ThisIsntTheWay/nixie_clock/resources/gerber/README.md

# Gerber files
This directory hosts various gerber files once they're ready for release.
