ThisIsntTheWay/nixie_clock/REFERENCES.md

# References
This document contains datasheets or various pinout diagrams/graphics for all the components used in this project.  
Note: None of the graphics are made by me and are just direct links to the source.

- [SN74HC595N - Shift register](https://i.imgur.com/DETzh7g.png)</br>
- [ESP32 (**Dev Kit**)](https://i2.wp.com/randomnerdtutorials.com/wp-content/uploads/2018/08/ESP32-DOIT-DEVKIT-V1-Board-Pinout-36-GPIOs-updated.jpg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)</br>
- [K155ID1 - BCD-To-DEC converter](https://tubehobby.com/datasheets/k155id1.pdf)</br>
  - [Example wiring](https://cdn.hackaday.io/images/408171416055153702.png)</br>
- [IN-16 - Nixie tube (RU)](https://tubehobby.com/datasheets/in16.pdf)
  - [Pinout graphic](http://www.tube-tester.com/sites/nixie/data/in-16/IN-16-pinout.jpg)
