ThisIsntTheWay/nixie_clock/resources/schematics/schematic_clock_direct_drive_REV4-BELOW.png

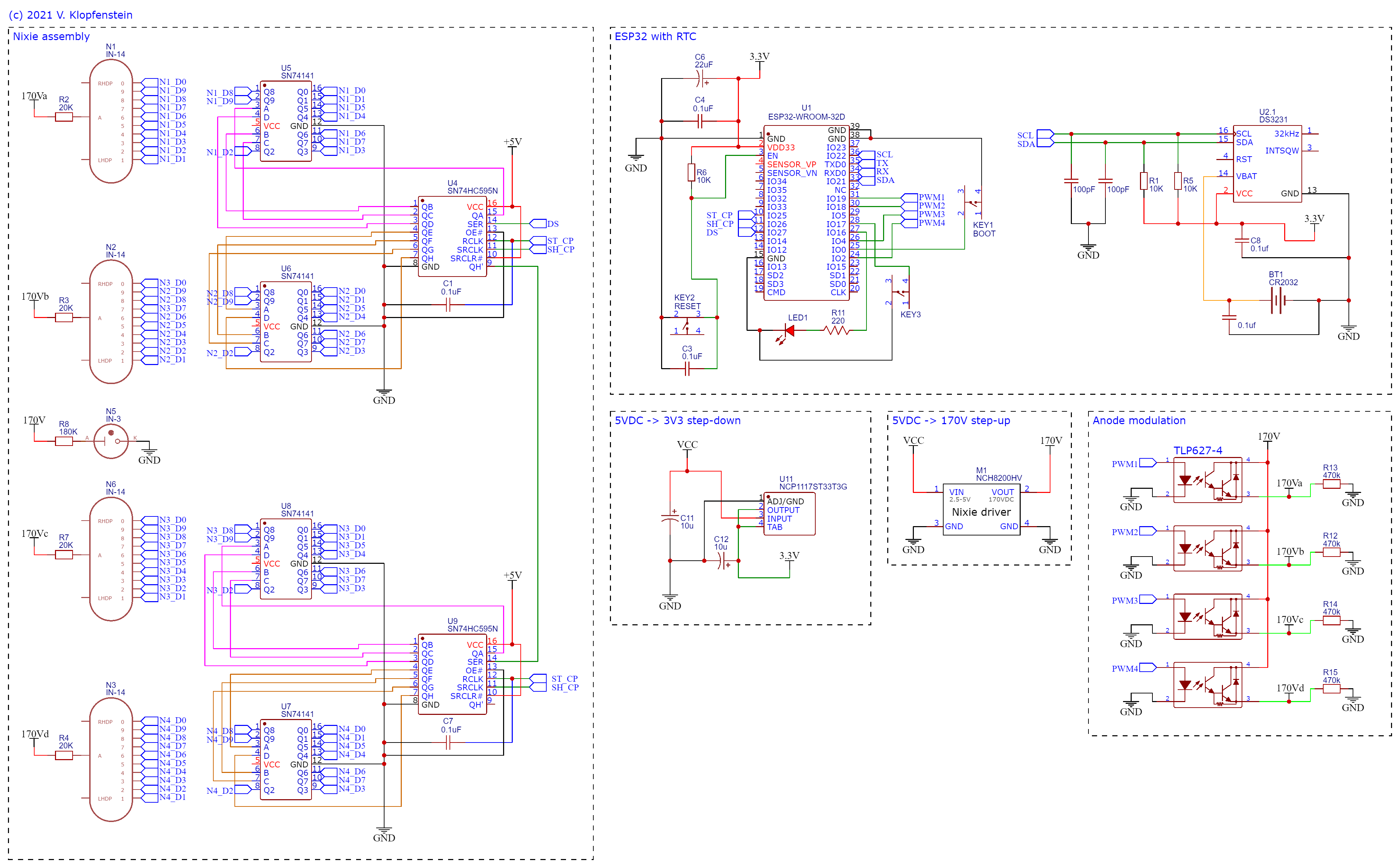
resources/schematics/schematic_clock_direct_drive_REV4-BELOW.png
