ThisIsntTheWay/nixie_clock/resources/schematics/schematic_clock_direct_drive_REV5-UP.png

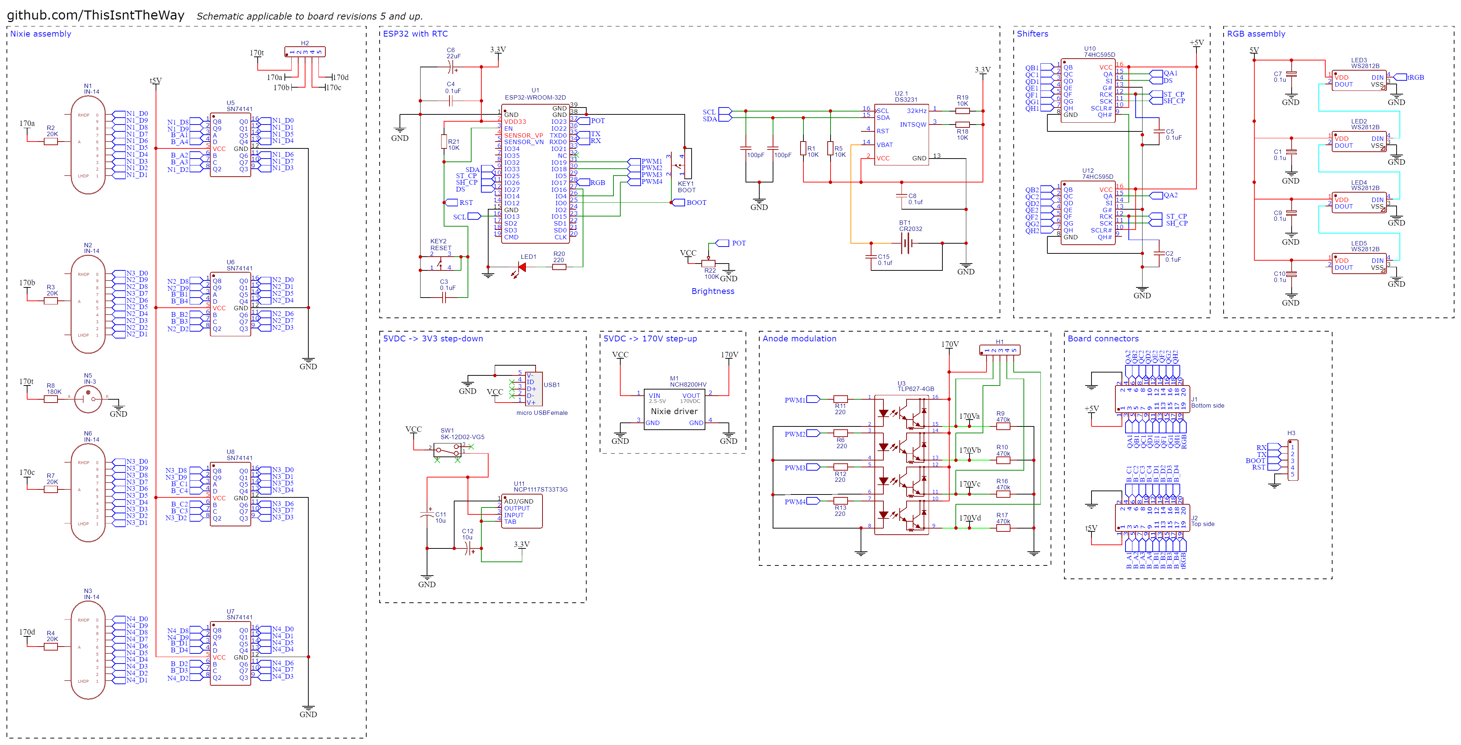
resources/schematics/schematic_clock_direct_drive_REV5-UP.png
