ThisIsntTheWay/nixie_clock/resources/3d_prints/in14_socket_v1.stl

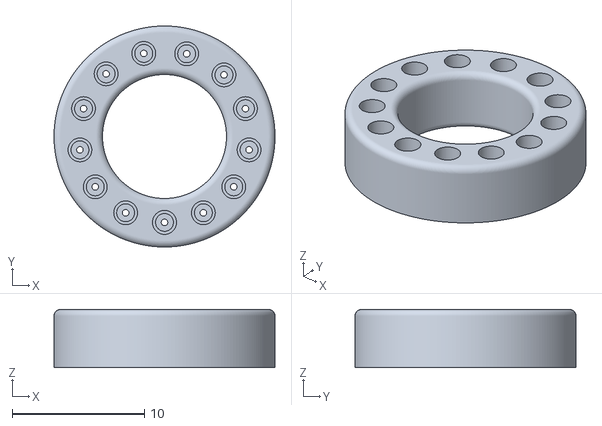
[picture p3: CAD file, 2021-08-19]
resources/3d_prints/in14_socket_v1.stl
16.7 x 16.7 x 4.40
