ThisIsntTheWay/nixie_clock/resources/3d_prints/README.md

## 3D Prints
This folder contains STLs of 3D printable models.  

### IN-14 Holder
  
Made for PCB footprints with the following dimensions:  
