ThisIsntTheWay/nixie_clock/(threads)

Thread 2 (2021-04-08):

Crash on FS mount

ThisIsntTheWay, 2021-04-08:
This has occurred after OTA partition removal and implementation of config files for network settings:
```
(MCU START)
[i] Spawning tasks...
[T] FS: Mounting...
[i] Done with setup().
[i] Free heap: [T] RTC: Starting setup...299568[T] Nixie: preparing nixie updater...
.
[io\lib
deps\esp32doit-devkit-v1\LittleFS_esp32\src\lfs.c:998:error: Corrupted dir pair at {0x0, 0x1}
E (80) esp_littlefs: mount failed,  (-84)
E (83) esp_littlefs: Failed to initialize LittleFS
[E][LITTLEFS.cpp:56] begin(): Mounting LITTLEFS failed! Error: -1
```

ThisIsntTheWay, 2021-04-08:
Fixed by re-introducing mklittlefs.exe as a replacement to PIOs native LittleFS binary builder.

Thread 3 (2021-05-17):

Time is sometimes invalid

ThisIsntTheWay, 2021-05-17:
Sometimes, RTClib produces invalid data, either because the RTC produces garbage or due to some other reason.
This leads to the nixie tubes not updating.

ThisIsntTheWay, 2021-05-19:
Next step: Investigate I2C signal.
Maybe add low-capacitance caps connecting the signals to GND.

ThisIsntTheWay, 2021-05-19:
Analysis has shown that the I2C clock line is fairly noisy.

Lowering the master I2C clock speed to 100kHz has largely mitigated, but not completely eradicated the issue.
However, RTClib now interprets the I2C data far less erroneously;
(It is within margin of error)

This issue is thus considered **fixed**, but will not be closed unless the error can be completely eradicated.

The aforementioned fix has been implemented in commit b108fdec81536a9b99450268fd336ffe5f6cfa82.

ThisIsntTheWay, 2021-05-19:
This issue has been further mitigated with the addition of two 47pF caps on both the data and clock lines;
```
SDA -- 47pF -- GND
SCL -- 47pF -- GND
```
Some instances with garbage data still exist though,

ThisIsntTheWay, 2021-06-01:
Confirmed fixed with the addition of 100pF caps on both I2C lines.

Closed 2021-06-01.

Thread 5 (2021-05-19):

Websockets server stalls on WiFi scan

ThisIsntTheWay, 2021-05-19:
Due to its implementation, the websockets instance stops responding to client messages during a WiFi scan.
This is a low-priority fix.

ThisIsntTheWay, 2021-06-20:
This phenomena is too low-priority to give attention to.

Closed 2021-06-20.

Thread 6 (2021-05-19):

Websockets server broadcasts messages to all clients

ThisIsntTheWay, 2021-05-19:
Currently, the websockets server sends its messages to all clients.
Whilst this is not a real problem, it would be nice to have the server send their messages to the actual origin.

ThisIsntTheWay, 2021-05-19:
Implemented in commit b95afe7c07b06c8e006aabfe8a15a01c8cc466dd

Closed 2021-05-19.

Thread 7 (2021-06-07):

Multiple definitions

ThisIsntTheWay, 2021-06-07:
After initially implementing classes, the compiler fails during the linking process due to multiple definitions:
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

Currently, #includes are nested like this:
```
main.cpp
	tasks.h
		nixie.h
			rtc.h
				sysInit.h
		rtc.h
			sysInit.h
	webserver.h
		rtc.h
			sysInit.h
		philipsHue.h
			sysInit.h
		nixie.h
			rtc.h
		utils.h
			sysInit.h
```

ThisIsntTheWay, 2021-06-20:
Implementation of classes will be pushed back, this issue will not be handled momentarily.

Closed 2021-06-20.
