ThisIsntTheWay/nixie_clock/(list of files, drawings)

Other design files:
resources/SCH_Nixie clock - v2_2021-07-23.json
