ThisIsntTheWay/nixie_clock/src/displayController.cpp

#include <displayController.h>
#include <timekeeper.h>

#define PULSATE_INTERVAL 5
#define MAX_PWM 150

/* -------------------
    Vars
   ------------------- */

Nixies nixies(DS_PIN, ST_PIN, SH_PIN);

int DisplayController::TubeVals[4][2] = {{9, 170}, {9, 170}, {9, 170}, {9, 170}};

bool DisplayController::AllowRESTcontrol = true;
bool DisplayController::DoDetox = false;
bool DisplayController::Clock = true;

uint8_t DisplayController::OnboardLedPWM = 20;
uint8_t DisplayController::OnboardLEDmode = 0;
uint8_t DisplayController::OnboardLEDblinkAmount = 0;
uint8_t DisplayController::DetoxCycle = 0;

DetoxInfo DisplayController::detoxInfo;

/* -------------------
    Main
   ------------------- */

void taskSetDisplay(void* parameter) {
    while (!nixies.IsReady()) {
        vTaskDelay(200);
    }

    Timekeeper timekeeper;

    for (;;) {
        int msMultiplier = 1;
        int t[4] = {11, 11, 11, 11};

        if (!timekeeper.RtcHealthy) {
            DisplayController::OnboardLEDmode = 2;
            DisplayController::OnboardLEDblinkAmount = 4;
        }

        if (DisplayController::Clock) {
            DisplayController::TubeVals[0][0] = timekeeper.time.hours / 10;
            DisplayController::TubeVals[1][0] = timekeeper.time.hours % 10;
            DisplayController::TubeVals[2][0] = timekeeper.time.minutes / 10;
            DisplayController::TubeVals[3][0] = timekeeper.time.minutes % 10;
        }
        
        if (!DisplayController::DoDetox) {
            // Normal routine
            for (int i = 0; i < 4; i++) {
                int8_t tubeVal = DisplayController::TubeVals[i][0];
                int8_t tubePWM = DisplayController::TubeVals[i][1];

                t[i] = tubeVal;

                // Fully turn off tube instead of leaving cathodes floating.
                if (tubeVal > 9)    { ledcWrite(i, 0); }
                else                { ledcWrite(i, tubePWM); }
            }

            nixies.SetDisplay(t);
        } else {
            // Detox cycle
            if (DisplayController::DetoxCycle <= 10) {
                msMultiplier = 75;
                for (int i = 0; i < 4; i++) {
                    t[i] = DisplayController::DetoxCycle;
                }

                DisplayController::DetoxCycle++;
                nixies.SetDisplay(t);
            } else {
                DisplayController::DetoxCycle = 0;
                DisplayController::DoDetox = false;
            }
        }
        
        vTaskDelay(TASK_TICK_DELAY * msMultiplier);
    }
}

// Status LED for ESP32
void taskSetStatusLED(void* parameter) {
    pinMode(ONBOARD_LED_PIN, OUTPUT);

    ledcSetup(ONBOARD_LEDC_CHANNEL, LEDC_PWM_FREQUENCY, 8);
    ledcAttachPin(ONBOARD_LED_PIN, ONBOARD_LEDC_CHANNEL);

    for (;;) {
        switch (DisplayController::OnboardLEDmode) {
            case 1:
                // Blink
                // -> LED is turned OFF but turns ON in a blinking matter
                for (int i = 0; i <= DisplayController::OnboardLEDblinkAmount; i++) {
                    ledcWrite(ONBOARD_LEDC_CHANNEL, DisplayController::OnboardLedPWM);
                    vTaskDelay(ONBOARD_LED_BLINK_INTERVAL);
                    ledcWrite(ONBOARD_LEDC_CHANNEL, 0);
                    vTaskDelay(ONBOARD_LED_BLINK_INTERVAL);
                }

                vTaskDelay(1000);
                break;
            case 2:
                // "Inverted" blink
                // -> LED is turned ON but turns OFF in a blinking matter
                ledcWrite(ONBOARD_LEDC_CHANNEL, DisplayController::OnboardLedPWM);
                for (int i = 0; i <= DisplayController::OnboardLEDblinkAmount; i++) {
                    ledcWrite(ONBOARD_LEDC_CHANNEL, 0);
                    vTaskDelay(ONBOARD_LED_BLINK_INTERVAL);
                    ledcWrite(ONBOARD_LEDC_CHANNEL, DisplayController::OnboardLedPWM);
                    vTaskDelay(ONBOARD_LED_BLINK_INTERVAL);
                }

                vTaskDelay(1000);
                break;
            case 3: {
                // Pulsate
                // Duty cycles above 150 are hardly perceived as brighter, so this value serves as the ceiling.
                for (int i = 0; i < MAX_PWM; i++) {
                    if (DisplayController::OnboardLEDmode != 3) break;

                    ledcWrite(ONBOARD_LEDC_CHANNEL, i);
                    vTaskDelay(ONBOARD_LED_PULSE_INTERVAL);
                }
                for (int i = MAX_PWM; i > 0; i--) {
                    if (DisplayController::OnboardLEDmode != 3) break;

                    ledcWrite(ONBOARD_LEDC_CHANNEL, i);
                    vTaskDelay(ONBOARD_LED_PULSE_INTERVAL);
                }
                break;
            }
            default:
                // Light up using specified PWM, a.k.a mode "0".
                ledcWrite(ONBOARD_LEDC_CHANNEL, DisplayController::OnboardLedPWM);
                break;
        }

        vTaskDelay(TASK_TICK_DELAY);
    }
}
