ThisIsntTheWay/nixie_clock/src/networkConfig.h

#ifndef NETCONFIG_H
#define NETCONFIG_H

#include <LITTLEFS.h>
#include <Arduino.h>
#include <ArduinoJson.h>
#include <WiFi.h>

class NetworkConfig {
    public:
        static String SSID;
        static String PSK;
        static bool IsAP;
        static bool IsStatic;
        static bool InInit;

        void InitConnection();
        bool WriteWiFiConfig(bool);
        bool WriteWiFiConfig(const char*, const char*);
        bool WriteWiFiConfig(const char*, const char*, bool);
        bool WriteIPConfig(JsonDocument&);
        bool ApplyNetConfig();

        String GetIPconfig(int8_t);

    private:
        String netFile = "/netConfig.json";

        const char* deviceIP;
        const char* netmask;
        const char* gateway;
        const char* dns1;
        const char* dns2;
        bool isStatic;

        bool parseNetConfig();
        void initSoftAP();
        bool splitIPaddress(char*, int*);
        
        const char *softAPssid = "Nixie Clock";
        const char *softAPpsk = "NixieClock123";
};

#endif
