ThisIsntTheWay/nixie_clock/src/terminalAux.h

#ifndef TERMINAL_H
#define TERMINAL_H

char vt_default_colour[] = "\x1B[39m";
char vt_red	[] = "\x1B[31m";
char vt_green	[] = "\x1B[32m";
char vt_yellow	[] = "\x1B[33m";
char vt_blue	[] = "\x1B[34m";
char vt_magenta	[] = "\x1B[35m";
char vt_cyan	[] = "\x1B[36m";
char vt_grey	[] = "\x1B[37m";

char vt_back_default_colour[] = "\x1B[49m";
char vt_back_red	[] = "\x1B[41m";
char vt_back_green	[] = "\x1B[42m";
char vt_back_yellow	[] = "\x1B[43m";
char vt_back_blue	[] = "\x1B[44m";
char vt_back_magenta	[] = "\x1B[45m";
char vt_back_cyan	[] = "\x1B[46m";
char vt_back_grey	[] = "\x1B[47m";

#endif
