ThisIsntTheWay/nixie_clock/(commit log)

2021-03-20 Webserver prototype
2021-03-20 RTC implementation (WIP)
    Create rtcConfig.cfg in SPI flash FS.
    Handling of contents is yet to be implemented.
2021-03-21 Fix kernel panic due to LittleFS
    [main.cpp, rtc.h, webServer.h]
2021-03-21 Fix template processing
    Template processor looks for strings with %%.
    It is required to use an additional % as an escape character.
    [main.cpp, webServer.h]
2021-03-21 Better handling of deserialization error
    [webServer.h]
2021-03-25 Short summary about file
    [main.cpp, nixie.h, philipsHue.h, rtc.h, webServer.h]
2021-03-26 New PCB
2021-03-27 Upload schematic
2021-03-27 getTime() return error if RTC is not ready
    [rtc.h]
2021-04-05 Update schematic... again
2021-04-06 Prod PCB Rev2
2021-04-07 Fix insufficient 'mode' length.
    [webServer.h]
2021-04-07 Fix RTC time update
    [nixie.h]
2021-04-07 Implement basic factory reset
    [main.cpp]
2021-04-07 Implement basic factory reset
    This time with more heap for the factory reset task.
    [main.cpp]
2021-04-07 Expose factory reset API endpoint
    [main.cpp, webServer.h]
2021-04-08 Remova OTA partition from MCU
    [part_no_OTA.csv]
2021-04-08 (Broken) Implement config file for network
    [main.cpp]
2021-04-08 Move schematic
2021-04-08 Add back mklittlefs.exe dep
    Turns out that the current code crashes if the FlashFS has been created without mklittlefs.exe
    [replace_fs.py]
2021-04-08 Add FS mount timeouts
2021-04-08 Move webserver startup into task
    This is kinda unnecessary, but I didn't want to have webServerStartup(); in the loop() function.
    [main.cpp, webServer.h]
2021-04-08 Skip NTP sync if ESP is in AP mode
    [rtc.h]
2021-04-08 Fix case sensitivity
2021-04-08 Improve error feedback and fix some errors
    [webServer.h]
2021-04-09 Fix rON & rOFF length threshold and remove comments
    [webServer.h]
2021-04-09 Better error handling in getHueLightIndex
    [philipsHue.h]
2021-04-09 Fix crash due to unsuccessful HTTP/GET
    The crash was due to ArduinoJson attempting to deserialize a HTTP GET stream that was invalid due to the ESP being unable to connect to the endpoint.
    To fix this, JSON parsing will only occur if http.GET() returns above 0
    [philipsHue.h]
2021-04-20 Work on fixing schedule for turning ON/OFF HUE lights.
    Does not yet turn on HUE lights, only off
    [philipsHue.h]
2021-04-20 Optimize code
    Implement decToBCD function to supersede the unnecessarily switch..case statement.
2021-05-15 Untested script to automatically remove libdep
    This script removes TinyWire from RTClib as a dependency, as it produces compiler errors on the ESP32 because it has no access to avr\interrupt.h
2021-05-15 Better handling of RTC failure
    No more crashing and improved verbosity.
    [rtc.h]
2021-05-16 Fix bitshift pins and logic
    [nixie.h]
2021-05-16 Fix nixie logic and add verbosity
    [nixie.h]
2021-05-16 Fix wrong display and implement manual nixie control
    This also fixes invalid time data from the RTC.
    [nixie.h]
2021-05-16 [Broken] Implement manual nixe display
    Produces HTTP/404 on valid GET request.
    [webServer.h]
2021-05-17 Fix invalid data length check for HUE API Endoint
    [webServer.h]
2021-05-17 Fix crash on deserialization error and improve feedback
    [philipsHue.h]
2021-05-17 Fix rOn & rOff filtering
    [webServer.h]
2021-05-17 New gerbers
2021-05-17 Improve deserialization error handling
    [rtc.h]
2021-05-17 Implement nixie tube control
2021-05-17 Change tube display and fix some if errors
    [webServer.h]
2021-05-19 Fix stack smashing protection failure
    Changed sprintf -> snprintf
    [rtc.h]
2021-05-19 Increase heap for taskUpdateRTC
    Stacktrace:
    CORRUPT HEAP: Bad head at 0x3ffd099c. Expected 0xabba1234 got 0x3ffd1ce0
    assertion "head != NULL" failed: file "/home/runner/work/esp32-arduino-lib-builder/esp32-arduino-lib-builder/esp-idf/components/heap/multi_heap_poisoning.c", line 249, function: multi_heap_realloc
    abort() was called at PC 0x4010e48f on core 0
    ELF file SHA256: 0000000000000000
    Backtrace: 0x4008906c:0x3ffd2bd0 0x400892e9:0x3ffd2bf0 0x4010e48f:0x3ffd2c10 0x4008da55:0x3ffd2c40 0x40081d64:0x3ffd2c60 0x40081dcd:0x3ffd2c80 0x400869a9:0x3ffd2ca0 0x4000bedd:0x3ffd2cc0 0x4017d3d6:0x3ffd2ce0 0x4017d463:0x3ffd2d20 0x4017df10:0x3ffd2d50 0x4017c6b1:0x3ffd2d70 0x4017c705:0x3ffd2d90 0x4017c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
    [main.cpp, rtc.h]
2021-05-19 Fix nixie clock mode not activating.
    [webServer.h]
2021-05-19 Workaround for 'bool manual' always being true
    [webServer.h]
2021-05-19 Fix websockets sending wrong SYS_DISMODE
    [webServer.h]
2021-05-19 Lower I2C clock speed to accommodate noisy SCL line
    RTClib interprets far less garbage with this change.
2021-05-20 Improve formatting of switch..case statement
2021-05-21 Fix logic, add time sanity check
    Removed minute comparisons for now
    [philipsHue.h]
2021-05-22 Update schematic
2021-06-06 Fix persistent NTP sync error
    Persistent as in the main menu (WebGUI) reporting an NTP sync error even though there was none (anymore).
    [webServer.h]
2021-06-06 Fix tube brightness reporting
    [webServer.h]
2021-06-06 Fix calculation of PWM as a percentage
    [nixie.h, webServer.h]
2021-06-06 Fix core panic due to HTTPClient
    displayCryptoPrice() and taskUpdateHUE() both used the same HTTPClient instance, thus crashing the core once either called http.end()
    [nixie.h, philipsHue.h]
2021-06-06 Workaround for brightness updates over REST
    [webServer.h]
2021-06-06 Remove unused 'Keep current' checkbox
2021-06-11 Increase PWM frequency
2021-06-11 Close nixie config file after switch..case
2021-06-11 Create/assign LED controller to individual opto channels
2021-06-11 Resolve race condition and increase PWM frequency
    [nixie.h]
2021-06-11 Fix opto pins again
    [nixie.h]
2021-06-11 Use separate RTC instances
    This hopefully fixes IntegerDivideByZero errors caused by DS3231::now().
    [nixie.h, philipsHue.h, rtc.h, webServer.h]
2021-06-11 Reboot system on network change
    [webServer.h]
2021-06-11 Fix cathode depoisoning logic
    [nixie.h]
2021-06-11 No longer print WiFi password in console
2021-06-11 Accommodate radio button CSS changes
2021-06-11 Omit brightness check if tubes should just get cycled
2021-07-23 Move files
    [SCH_Nixie clock - v2_2021-07-23.json]
2021-08-02 Major code rewrite
    [partition_table.csv]
2021-08-02 More I2C flexibility
2021-08-02 Prepare for board REV5
2021-08-02 Implement I2C slowmode flag
2021-08-09 Implement onboard LED
    For PCB REV5 and up
2021-08-09 Update RTC logic to board REV5
2021-08-09 Control onboard LED using LEDC
    Just to control the brightness.
2021-08-18 Add STL
    [in14_socket_v1.stl]
2021-08-18 Change PCB footprint image size
2021-08-19 i2c lock [WIP]
2021-10-03 Add more comments and fix incorrect register check during checkStartup()
    [rtc.cpp]
2021-10-03 Update oPins to newest PCB revision
2021-10-03 Update nixieTest.ino
    Lower initial PWM frequency
2021-10-04 Change changeDisplay() (untested)
    Also implement logic for inversed nixie socket footprints
2021-10-04 Fix numCache and BCD data arrangement
    [nixies.cpp]
2021-10-17 Add in missing '}'
    [main.cpp]
2021-10-17 Bootstrap system configuration JSON
    For now only contains a bool for keeping the onboard LED on post bootup procedure.
    Also moved some vars around.
2021-10-22 Resize filesystem
    Decrease SPIFFs space, increase OTA partitions.
    [partition_table.csv]
2021-10-22 Fix spiffs flash sector alignement
    [partition_table.csv]
2021-10-31 Fix radio buttons
2022-02-20 Implement rack_nixie_display codebase.
    Missing: RTC, updated WebGUI.
    [displayController.cpp, displayController.h, main.cpp, networkConfig.cpp, networkConfig.h, nixies.cpp]
2022-02-20 Move footprint inversion hotfix to nixies.cpp.
2022-02-20 Lower initial O_LED PWM, fix pulsation.
    [displayController.cpp]
2022-02-20 Blink onboard LED on RTC failure, change operation of clock mode.
    [displayController.cpp]
2022-02-23 Decrease detox cycle delay and initial tube PWM.
2022-03-27 Fix undefined reference to struct.
    [displayController.cpp]
